Orbitar/orbitar/README.md

Orbitar
=======
The Orbitar is a new multimedia musical instrument rooted in the ancient art of poi spinning.
