Orbitar/orbitar/doc/xbee_explorer_mod.png

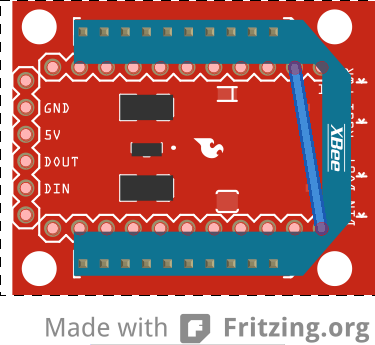
doc/xbee_explorer_mod.png
