Orbitar/orbitar/(list of files, drawings)

Other design files:
doc/xbee_explorer_mod.fzz
