Orbitar/orbitar/pcb/orb.brd

## EAGLE design pcb/orb.brd (2013-07-21)

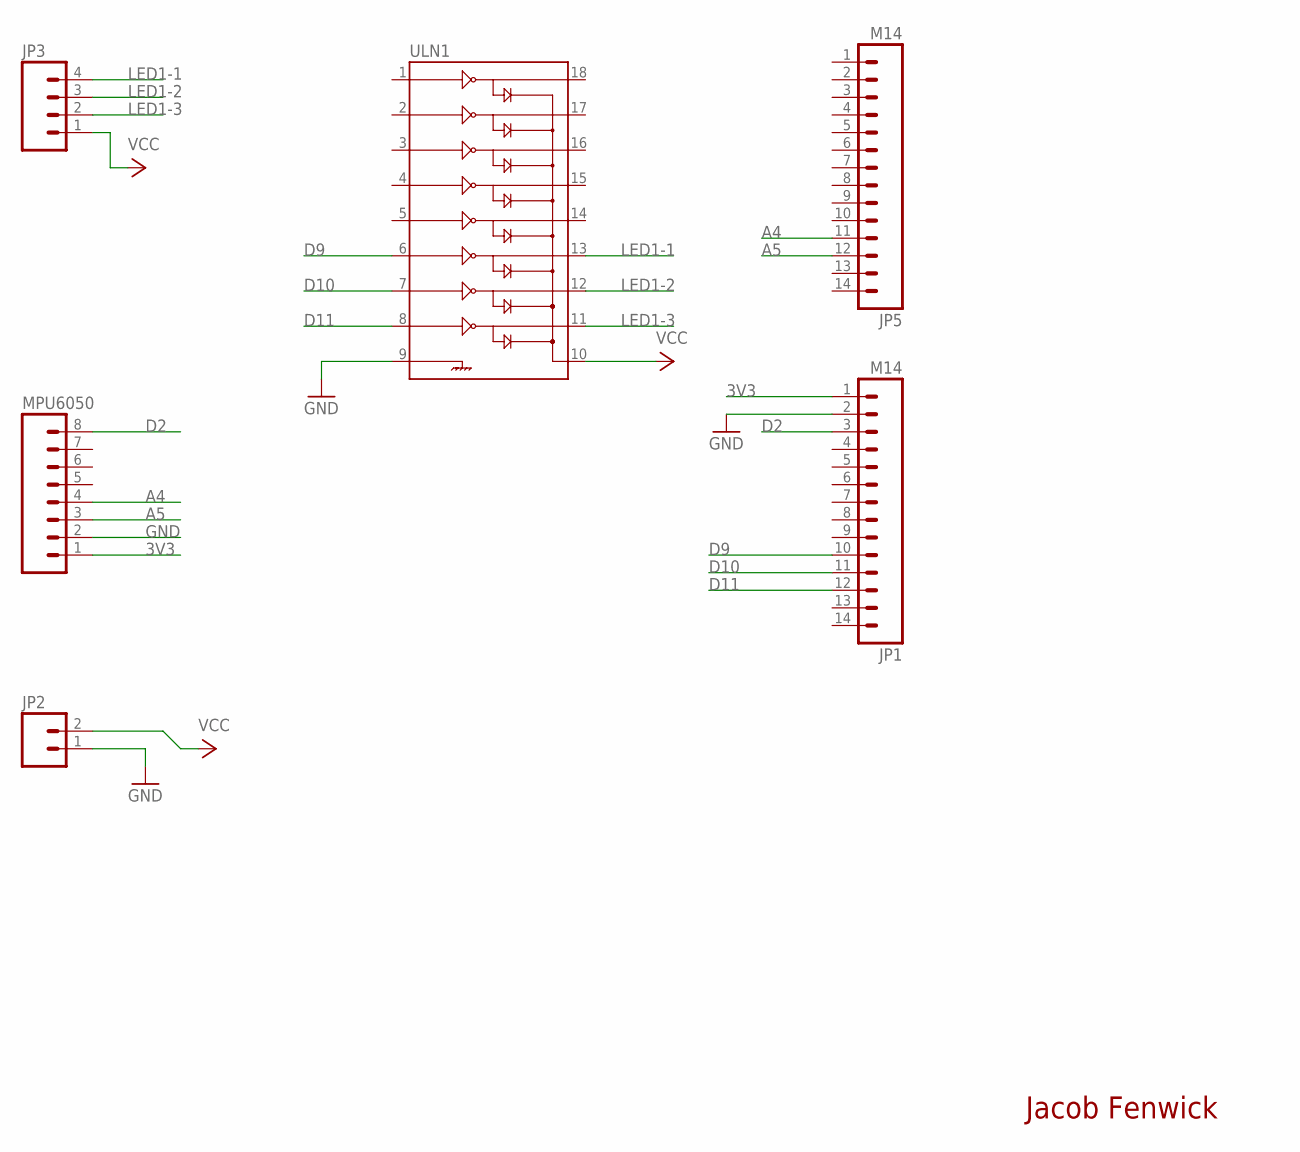
[picture p2: schematic orb.sch]

Parts:
JP1, JP5: M14; 1X14
JP2: M02PTH; 1X02
JP3: M04PTH; 1X04
MPU6050: M081X08; 1X08
ULN1: ULN2803DIP; DIL18

Connections:
3V3: JP1.1, MPU6050.1
A4: JP5.11, MPU6050.4
A5: JP5.12, MPU6050.3
D2: JP1.3, MPU6050.8
D9: JP1.10, ULN1.6
D10: JP1.11, ULN1.7
D11: JP1.12, ULN1.8
GND: JP1.2, JP2.1, MPU6050.2, ULN1.9
LED1-1: JP3.4, ULN1.13
LED1-2: JP3.3, ULN1.12
LED1-3: JP3.2, ULN1.11
VCC: JP2.2, JP3.1, ULN1.10

Notes on the sheet:
Jacob Fenwick

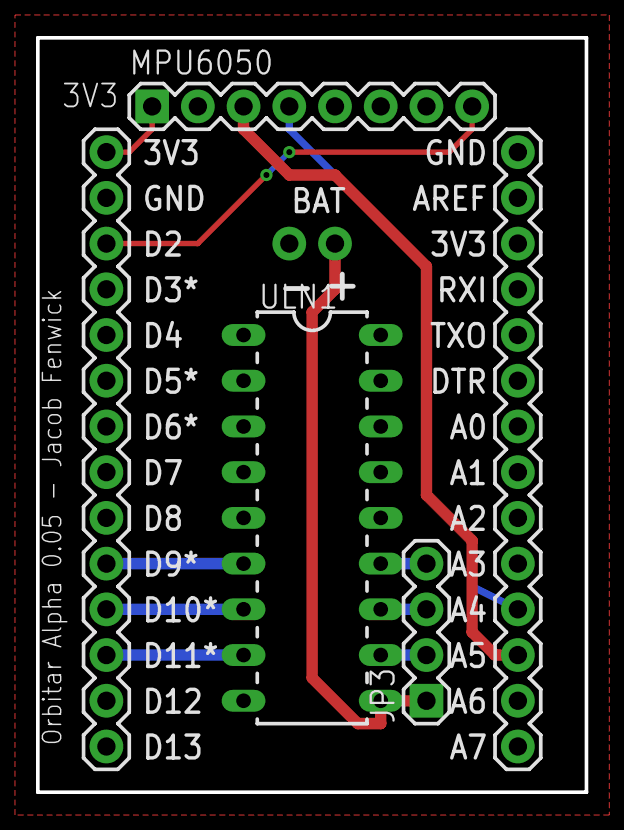
[picture p3: board orb.brd from above]

Board: 2 copper layers, 30.5 x 41.9 mm, 6 parts (1 on the bottom side), 12 nets.
