Orbitar/orbitar/doc/shield_assembly.pdf

# you'llneed 1

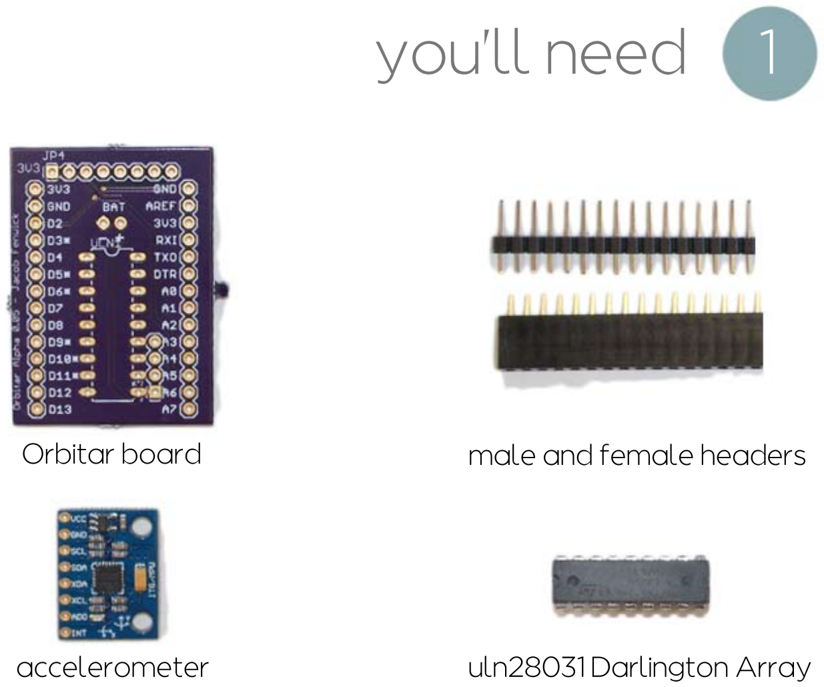
[picture p4: page 1]

uln28031DarlingtonArray

Orbitarboard

accelerometer

maleandfemaleheaders

## attachthe darlingtonarray

Bendthepinsinslightlysoit
alignsproperlywiththeboard

2

Putthedarlingtonarrayinplace. Makesurethedivetmatchesthe divetontheboard.

Turntheboardoverand
solderallofthepins.

## attachheadersforarduinoconnection 3

Breakoff8headerstofillA0-A7, and14headerstofillallthe
holesontheotherside.

Toensureyousolderthepinsstraight, insertthelongsideoftheheadersinto yourarudino.ThenputyourOrbitar boardontop.Solderallpins.

## soldersomemorethings 4

Breakoff2headersforthebatteryslotand 4headersfortheLEDslot.Insertintothe boardwiththelongpinfacingup.Solder.

Breakoff8female
headersforthe
sensorslot.Solder.

anditshouldnowlooklikethis!

## theaccelerometer 5

Breakoff8pinsfortheaccelerometer. Insertintothefemaleheadersontheboard.

Solder,andvoila!
