Orbitar/orbitar/(commit log)

2013-07-21 working version of breakout board uploaded
    [orb.brd, orb.sch]
2013-07-21 changed name of component to reflect it's where the sensor goes
    [orb.brd, orb.sch]
2013-07-22 added force system simulator. currently only moves ball on y axis of screen
2013-07-22 added arduino firmware
2013-07-26 added capability to drag and drop wav files onto audio sample example
2013-08-15 started bill of materials
2013-08-15 added bluetooth bee to bom
2013-08-17 added diagram for xbee explorer modification for the bluetooth bee
    [xbee_explorer_mod.fzz]
2013-08-17 added lipo to bom
2013-08-20 changed orb arduino code and basic max patch to expose real acceleration data with gravity extracted
2013-09-22 changed orb firmware to output gyro data. Added patch to show velocity information controlled from gyro
2013-10-27 added tuned vocals, fixed LED bug in first piece
2013-10-28 addressed led/delay/reset issue
2013-11-26 added flowshow folder
